audy910/LED-PCB-Controller/LightBoxPCB.kicad_pcb

## KiCad design LightBoxPCB.kicad_pcb (2026-10-21)

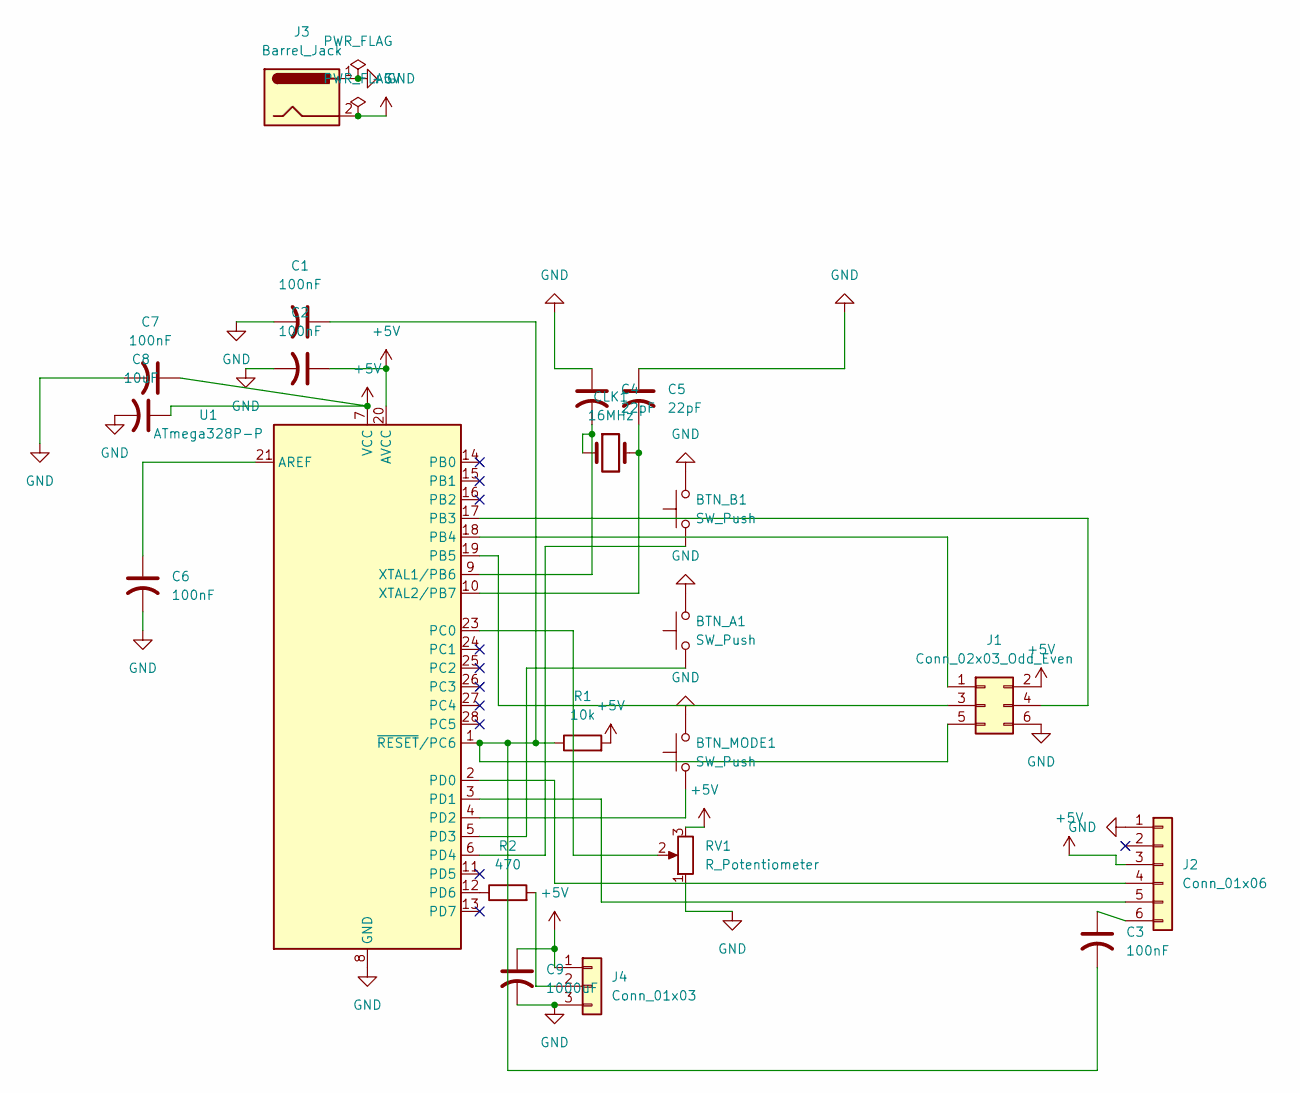
[picture p2: schematic LightBoxPCB.kicad_sch]

Parts:
BTN_A1: SW_Push; SW_PUSH-12mm
BTN_B1: SW_Push; SW_PUSH-12mm
BTN_MODE1: SW_Push; SW_PUSH-12mm
C1, C2, C3, C6, C7: 100nF; C_Disc_D5.0mm_W2.5mm_P5.00mm
C4, C5: 22pF; C_Disc_D5.0mm_W2.5mm_P5.00mm
C8: 10uF; CP_Radial_D5.0mm_P2.50mm
C9: 1000uF; CP_Radial_D10.0mm_P5.00mm
CLK1: 16MHz; Crystal_HC49-4H_Vertical
J1: Conn_02x03_Odd_Even; PinHeader_2x03_P2.54mm_Vertical
J2: Conn_01x06; PinHeader_1x06_P2.54mm_Vertical
J3: Barrel_Jack; BarrelJack_Wuerth_6941xx301002
J4: Conn_01x03; PinHeader_1x03_P2.54mm_Vertical
R1: 10k; R_Axial_DIN0207_L6.3mm_D2.5mm_P10.16mm_Horizontal
R2: 470; R_Axial_DIN0207_L6.3mm_D2.5mm_P10.16mm_Horizontal
RV1: R_Potentiometer; Potentiometer_Alps_RK09L_Single_Vertical
U1: ATmega328P-P; DIP-28_W7.62mm

Connections:
+5V: C2.1, C7.1, C8.1, C9.1, J1.2, J2.3, J3.2, J4.1, R1.2, RV1.3, U1.7 (VCC), U1.20 (AVCC)
GND: BTN_A1.2, BTN_B1.2, BTN_MODE1.2, C1.2, C2.2, C4.1, C5.1, C6.2, C7.2, C8.2, C9.2, J1.6, J2.1, J3.1, J4.3, RV1.1, U1.8 (GND), U1.22 (GND)
unnamed: J1.1, U1.18 (PB4)
unnamed: J1.3, U1.19 (PB5)
unnamed: J1.4, U1.17 (PB3)
unnamed: C1.1, C3.2, J1.5, R1.1, U1.1 (~RESET/PC6)
unnamed: J2.4, U1.2 (PD0)
unnamed: J2.5, U1.3 (PD1)
unnamed: C3.1, J2.6
unnamed: J4.2, R2.2
unnamed: C6.1, U1.21 (AREF)
unnamed: RV1.2, U1.23 (PC0)
unnamed: BTN_MODE1.1, U1.4 (PD2)
unnamed: BTN_A1.1, U1.5 (PD3)
unnamed: BTN_B1.1, U1.6 (PD4)
unnamed: R2.1, U1.12 (PD6)
unnamed: C4.2, CLK1.1, U1.9 (XTAL1/PB6)
unnamed: C5.2, CLK1.2, U1.10 (XTAL2/PB7)

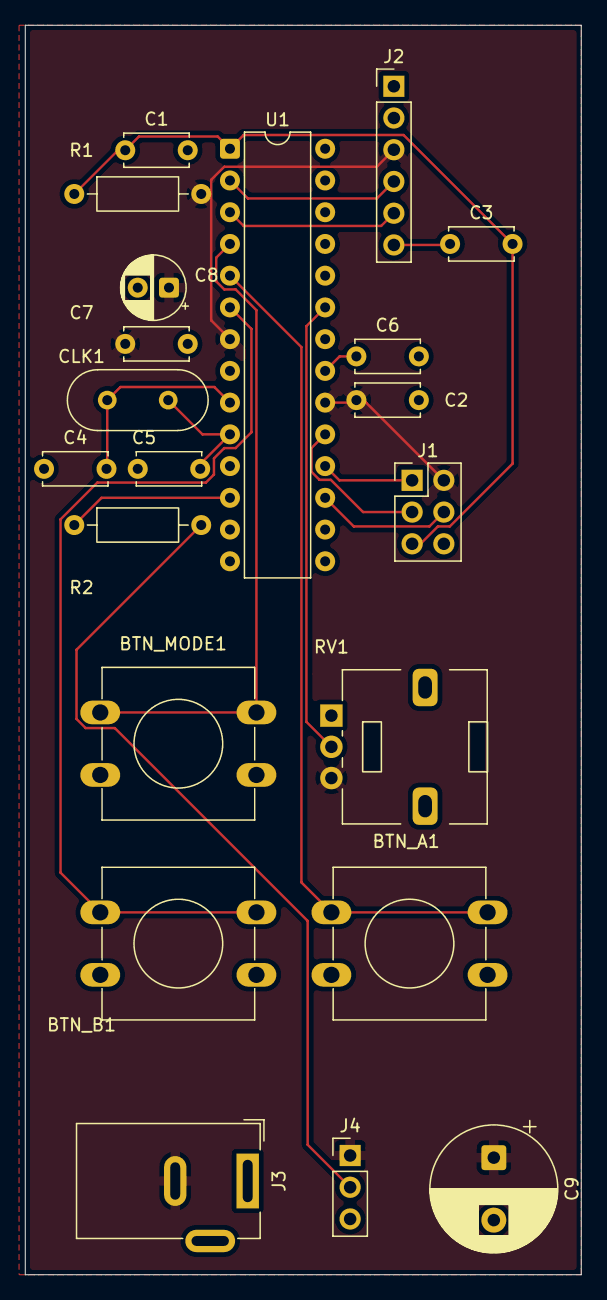
[picture p3: board LightBoxPCB.kicad_pcb from above]

Board: 2 copper layers, 44.5 x 100.0 mm, 21 parts (0 on the bottom side), 18 nets.
